I-AM-ENGINEER/Seismometer-esp32/README.md

#Work in progress

# Seismometer-esp32
ESP32 based wifi vibration &amp; sound sensor with realtime streaming captured audio throught mqtt
