I-AM-ENGINEER/Seismometer-esp32/PCB/v1.0/README.md

#First prototype

##Errors:

1) R10 should be connected to VREF, not to GND
2) Microphone amplifier (U8) is broken, maybe contrafact IC

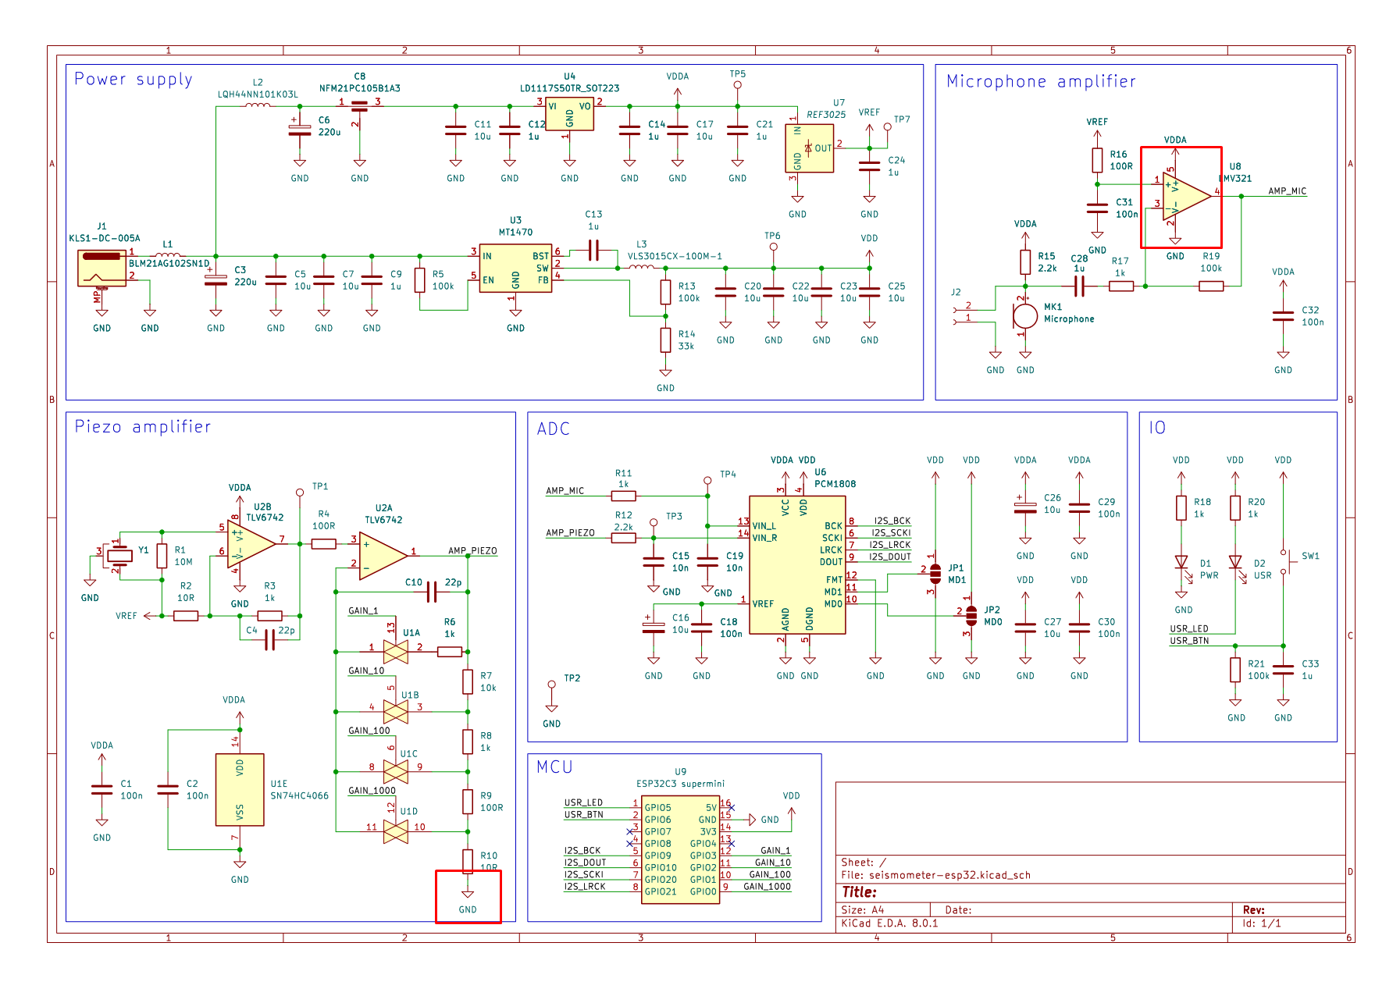
[picture p1: PCB/v1.0/Schematic.png]
Schematic Schematic with highlighted errors
