I-AM-ENGINEER/Seismometer-esp32/MyResearch/tsf_samplerates_compare/README.md

FreeRTOS reconfigured for 1000Hz tickrate
