I-AM-ENGINEER/Seismometer-esp32/MyResearch/tsf_mesh_function_compare/data/README.md

Every file contan 5min capture (period 100ms) with 3 value:

timer_value1	tsf_function_value	timer_value2

Timer clock 40MHz, tsf_function return AP timestamp in microseconds. Timer value captured before and after tsf function for getting function process time
