I-AM-ENGINEER/Seismometer-esp32/Docs/Блок-схема/Блок схема.png

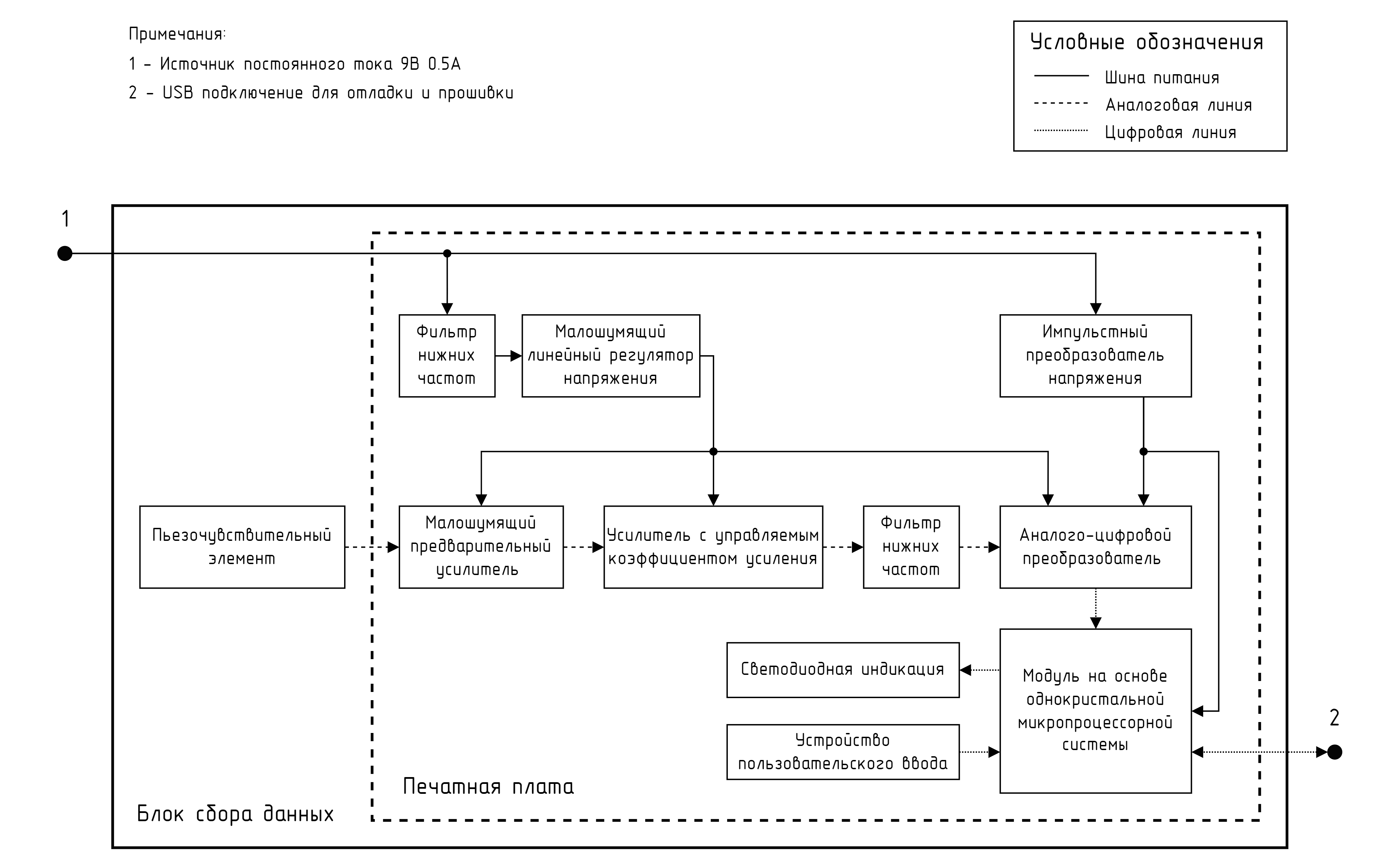
Docs/Блок-схема/Блок схема.png
