I-AM-ENGINEER/Seismometer-esp32/PCB/v1.0/BOM.xlsx

Reference | Value | Qty
C1,C2,C18,C29,C30,C31,C32 | 100n | 7
C3,C6 | 220u | 2
C4,C10 | 22p | 2
C5,C7,C11,C16,C17,C20,C22,C23,C25,C26,C27 | 10u | 11
C8 | NFM21PC105B1A3 | 1
C9,C12,C13,C14,C21,C24,C28,C33 | 1u | 8
C15,C19 | 10n | 2
J1 | KLS1-DC-005A | 1
L1 | BLM21AG102SN1D | 1
L2 | LQH44NN101K03L | 1
L3 | VLS3015CX-100M-1 | 1
MK1 | Microphone | 1
R1 | 10M | 1
R2,R10 | 10R | 2
R3,R6,R8,R11,R17,R18,R20 | 1k | 7
R4,R9,R16 | 100R | 3
R5,R13,R19,R21 | 100k | 4
R7 | 10k | 1
R12,R15 | 2.2k | 2
R14 | 33k | 1
U1 | SN74HC4066 | 1
U2 | TLV6742 | 1
U3 | MT1470 | 1
U4 | LD1117S50TR_SOT223 | 1
U6 | PCM1808 | 1
U7 | REF3025 | 1
