I-AM-ENGINEER/Seismometer-esp32/PCB/v1.0/seismometer-esp32.step

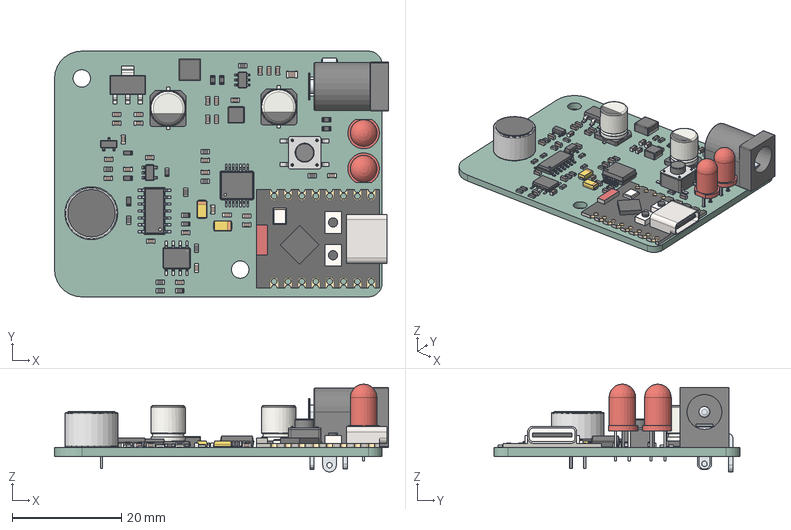
[picture p3: CAD file, 2024-10-25]
PCB/v1.0/seismometer-esp32.step
61.2 x 45.0 x 16.1 mm
CP_Elec_63x77 x 2
L_Cenker_CKCS3015
SSOP_8_39x505mm_P127mm
C_0603_1608Metric x 28
R_0603_1608Metric x 21
SOT_23
SOT_223
LED_D5.0mm x 2
TSOT_23_6
Microphone
CP_EIA_3216_12_Kemet_S x 2
Small_pushbutton_pad
SOT_23_5
ESP32-C3 SuperMini
C_0805_2012Metric
L_Cenker_CKCS4020
CQ assembly
DC_Barrel_Assy
SSOP_14_53x62mm_P065mm
seismometer-esp32_PCB
