I-AM-ENGINEER/Seismometer-esp32/(list of files, cad)

Other CAD files:
Case/35mm-sensor.ipt
Case/Assembly.iam
Case/Assembly1.iam
Case/ESP32-C3 SuperMini.ipt
Case/Main body.ipt
Case/Part1.ipt
Case/Part2.ipt
Case/seismometer-esp32.ipt
