I-AM-ENGINEER/Seismometer-esp32/PCB/v1.0/seismometer-esp32.pdf

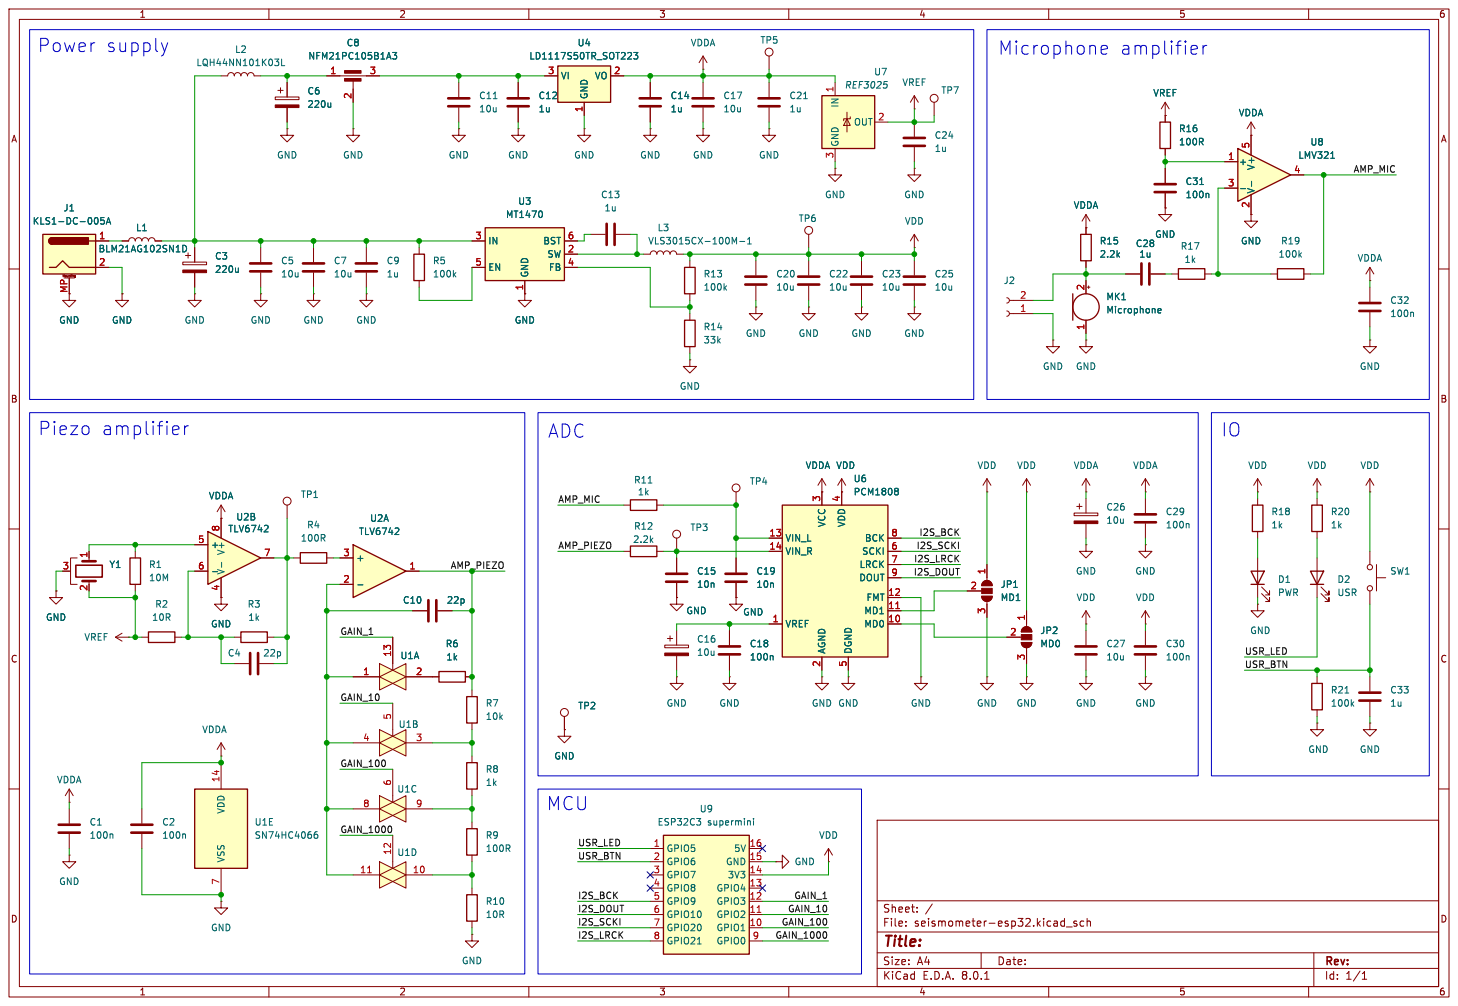
[picture p4: page 1]

Id: 1/1 Title: File: seismometer-esp32.kicad_sch Sheet: / GND

LRCK 7 BCK 8 DOUT 9 VDDA VDD GND

LRCK 7 BCK 8 DOUT 9 U6PCM1808 VDDA
