I-AM-ENGINEER/Seismometer-esp32/Docs/PCB-altium/Export/Schematic.pdf

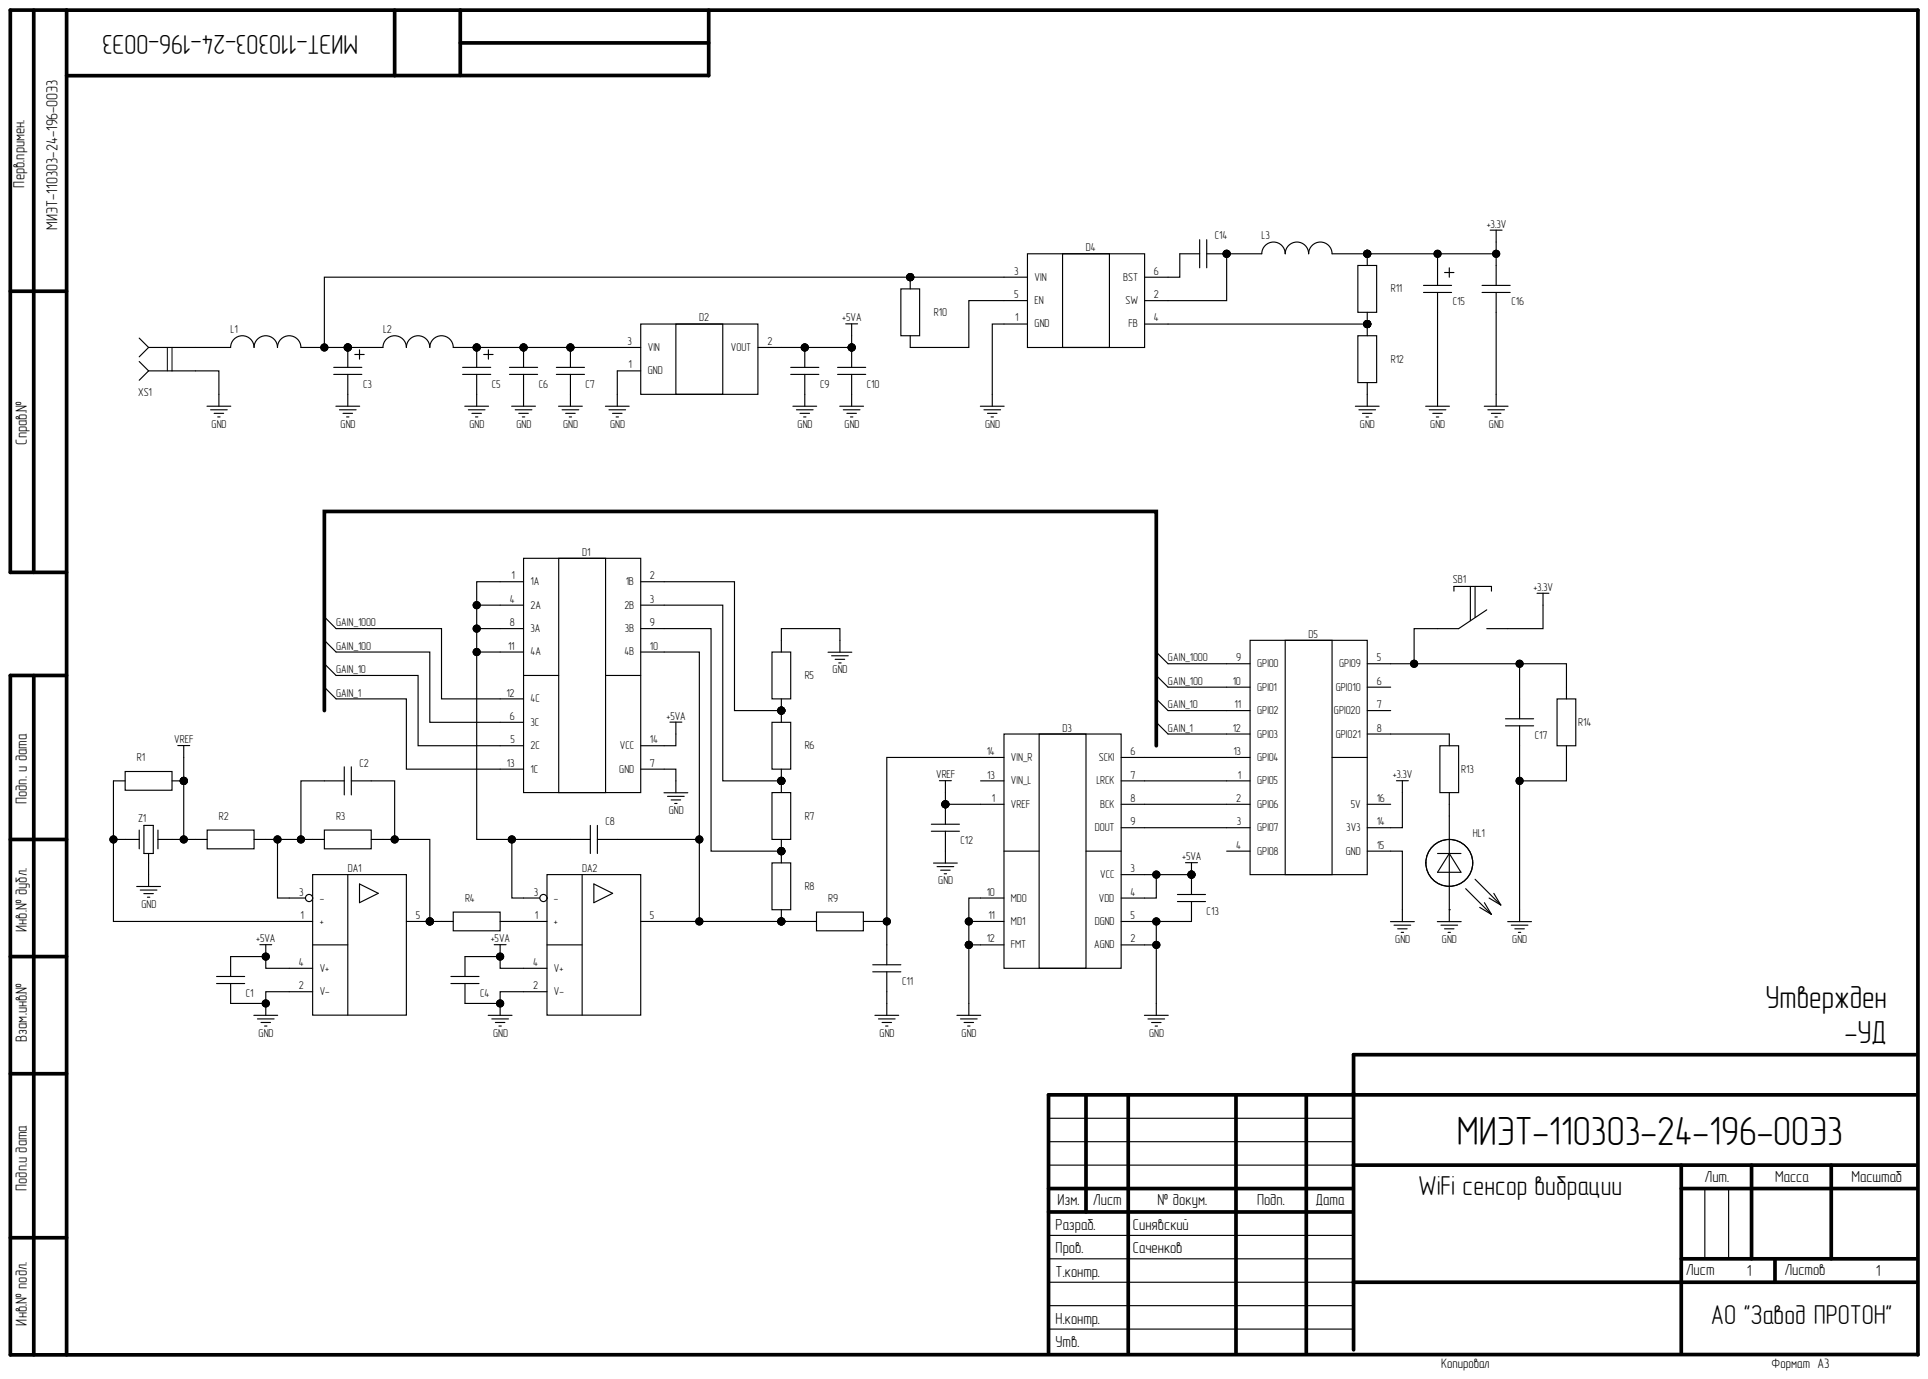
[picture p5: page 1]

Инв.№ подл. Подп.и дата Взам.инв.№ Инв.№ дубл. Подп. и дата Справ.№ Перв.примен.

VIN 3 | SW

GND 1

GAIN_100 | | | | 10

GAIN_10 | | | | | 14

GAIN_1 | | 4C 12 | | VCC

МИЭТ-110303-24-196-00Э3

WiFi сенсор вибрации | Лит. | Масса | Масштаб

Изм. | Лист | № докум. | Подп. | Дата
Разраб. | | Синявский
Пров. | | Саченков
Т.контр. | | | | | Лист 1 | Листов 1

Н.контр.
Утв.

АО "Завод ПРОТОН"
