I-AM-ENGINEER/Seismometer-esp32/Docs/PCB-altium/Export/Сборочный.pdf

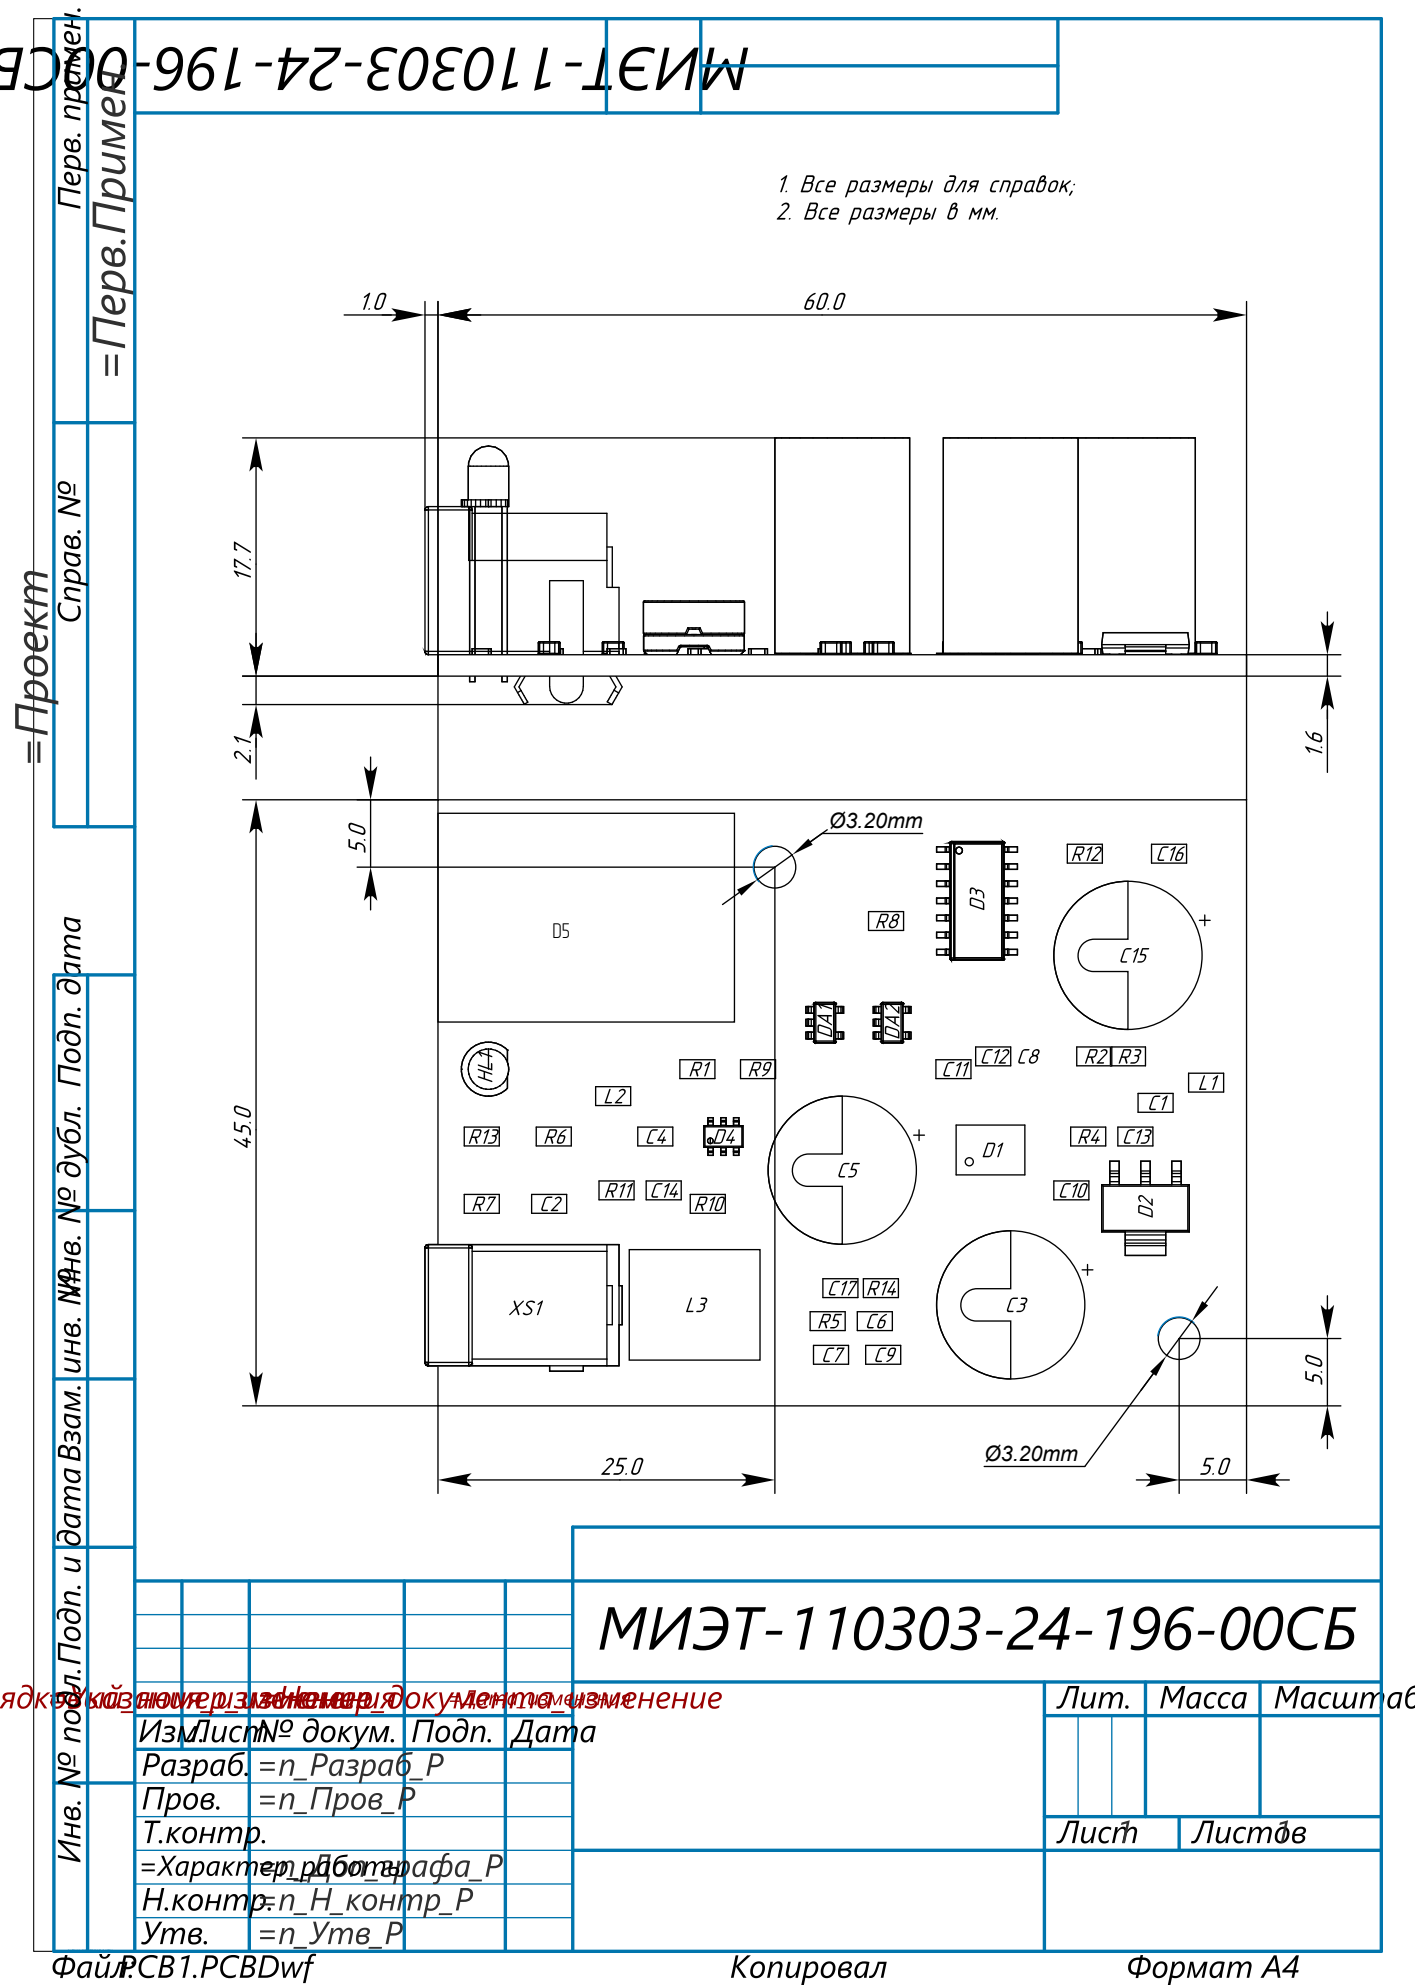
[picture p6: page 1]
ALTIUM GOSTBOM2.0 KEV
