I-AM-ENGINEER/Seismometer-esp32/(list of files, drawings)

Other design files:
Docs/PCB-altium/PCB1.PcbDoc
Docs/PCB-altium/Schlib1.SchLib
Docs/PCB-altium/SeismometerAltium.PrjPcb
Docs/PCB-altium/Sheet1.SchDoc
