I-AM-ENGINEER/Seismometer-esp32/PCB/v1.0/seismometer-esp32.kicad_pcb

## KiCad design PCB/v1.0/seismometer-esp32.kicad_pcb (2024-10-25)

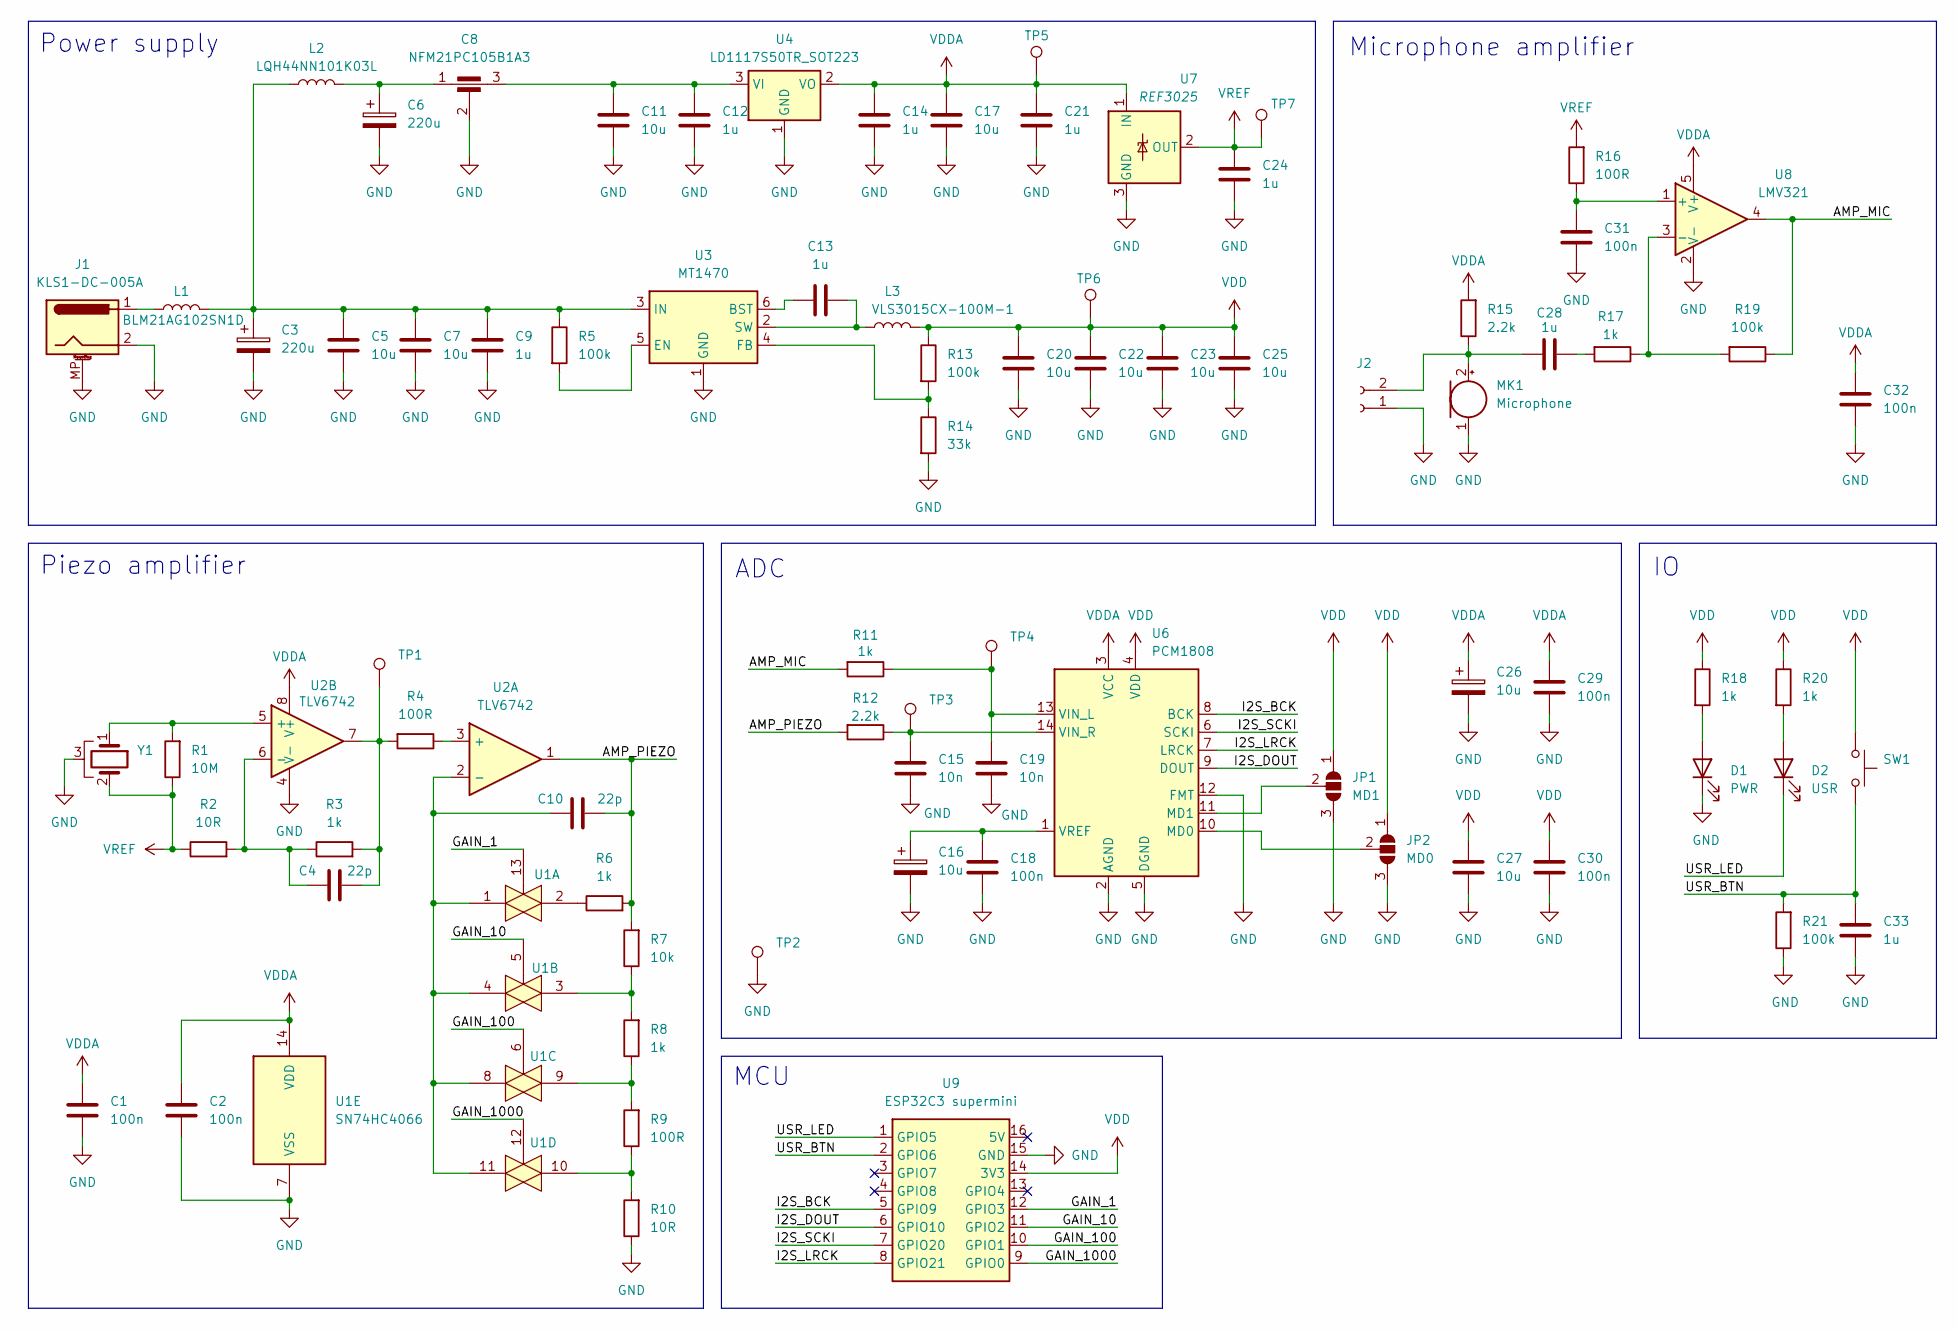
[picture p7: schematic seismometer-esp32.kicad_sch]

Parts:
C1, C2, C18, C29, C30, C31, C32: 100n; C_0603_1608Metric_Pad1.08x0.95mm_HandSolder
C3, C6: 220u; CP_Elec_6.3x7.7
C4, C10: 22p; C_0603_1608Metric_Pad1.08x0.95mm_HandSolder
C5, C7, C11, C17, C20, C22, C23, C25, C27: 10u; C_0603_1608Metric_Pad1.08x0.95mm_HandSolder
C8: NFM21PC105B1A3; NFM21PC
C9, C12, C13, C14, C21, C24, C28, C33: 1u; C_0603_1608Metric_Pad1.08x0.95mm_HandSolder
C15, C19: 10n; C_0603_1608Metric_Pad1.08x0.95mm_HandSolder
C16, C26: 10u; CP_EIA-3216-12_Kemet-S_Pad1.58x1.35mm_HandSolder
D1: PWR; LED_D5.0mm
D2: USR; LED_D5.0mm
J1: KLS1-DC-005A; BarrelJack_Kycon_KLDX-0202-xC_Horizontal
J2: Conn_01x02_Socket; PinHeader_1x02_P2.00mm_Vertical
JP1: MD1; SolderJumper-3_P1.3mm_Open_RoundedPad1.0x1.5mm
JP2: MD0; SolderJumper-3_P1.3mm_Open_RoundedPad1.0x1.5mm
L1: BLM21AG102SN1D; C_0805_2012Metric
L2: LQH44NN101K03L; L_Taiyo-Yuden_NR-40xx_HandSoldering
L3: VLS3015CX-100M-1; L_Taiyo-Yuden_NR-30xx_HandSoldering
MK1: Microphone; DGO9465CD
R1: 10M; R_0603_1608Metric_Pad0.98x0.95mm_HandSolder
R2, R10: 10R; R_0603_1608Metric_Pad0.98x0.95mm_HandSolder
R3, R6, R8, R11, R17, R18, R20: 1k; R_0603_1608Metric_Pad0.98x0.95mm_HandSolder
R4, R9, R16: 100R; R_0603_1608Metric_Pad0.98x0.95mm_HandSolder
R5, R13, R19, R21: 100k; R_0603_1608Metric_Pad0.98x0.95mm_HandSolder
R7: 10k; R_0603_1608Metric_Pad0.98x0.95mm_HandSolder
R12, R15: 2.2k; R_0603_1608Metric_Pad0.98x0.95mm_HandSolder
R14: 33k; R_0603_1608Metric_Pad0.98x0.95mm_HandSolder
SW1: SW_Push; SW_Push_1P1T_NO_6x6mm_H9.5mm
TP1, TP2, TP3, TP4, TP5, TP6, TP7: TestPoint; TestPoint_Pad_D2.0mm
U1: SN74HC4066; SO-14_3.9x8.65mm_P1.27mm
U2: TLV6742; SSOP-8_3.9x5.05mm_P1.27mm
U3: MT1470; TSOT-23-6
U4: LD1117S50TR_SOT223; SOT-223-3_TabPin2
U6: PCM1808; SSOP-14_5.3x6.2mm_P0.65mm
U7: REF3025; SOT-23
U8: LMV321; SOT-23-5
U9: ESP32C3 supermini; ESP32C3-supermini
Y1: Crystal_GND3; Shielded cable 2pin

Connections:
/AMP_MIC: R11.2, R19.1, U8.4
/AMP_PIEZO: C10.2, R6.2, R7.2, R12.2, U2.1
/GAIN_1: U1.13, U9.12 (GPIO3)
/GAIN_10: U1.5, U9.11 (GPIO2)
/GAIN_100: U1.6, U9.10 (GPIO1)
/GAIN_1000: U1.12, U9.9 (GPIO0)
/I2S_BCK: U6.8 (BCK), U9.5 (GPIO9)
/I2S_DOUT: U6.9 (DOUT), U9.6 (GPIO10)
/I2S_LRCK: U6.7 (LRCK), U9.8 (GPIO21)
/I2S_SCKI: U6.6 (SCKI), U9.7 (GPIO20)
/USR_BTN: C33.1, R21.2, SW1.2, U9.2 (GPIO6)
/USR_LED: D2.1 (K), U9.1 (GPIO5)
GND: C1.2, C2.2, C3.2, C5.2, C6.2, C7.2, C8.2, C9.2, C11.2, C12.2, C14.2, C15.2, C16.2, C17.2, C18.2, C19.2, C20.2, C21.2, C22.2, C23.2, C24.2, C25.2, C26.2, C27.2, C29.2, C30.2, C31.1, C32.2, C33.2, D1.1 (K), J1.2, J1.MP (MountPin), J2.1, JP1.3 (B), JP2.3 (B), MK1.1 (-), R10.1, R14.2, R21.1, TP2.1, U1.7 (VSS), U2.4 (V-), U3.1 (GND), U4.1 (GND), U6.2 (AGND), U6.5 (DGND), U6.12 (FMT), U7.3 (GND), U8.2 (V-), U9.15 (GND), Y1.3
unnamed: C4.2, R3.2, R4.2, TP1.1, U2.7
unnamed: C6.1, C8.1, L2.2
unnamed: C28.2, R17.2
unnamed: D1.2 (A), R18.2
unnamed: D2.2 (A), R20.2
unnamed: J1.1, L1.1
unnamed: C28.1, J2.2, MK1.2 (+), R15.1
unnamed: JP1.2 (C), U6.11 (MD1)
unnamed: JP2.2 (C), U6.10 (MD0)
unnamed: R6.1, U1.2
unnamed: R7.1, R8.2, U1.3
unnamed: R8.1, R9.2, U1.9
unnamed: R9.1, R10.2, U1.10
unnamed: R4.1, U2.3 (+)
unnamed: C10.1, U1.1, U1.4, U1.8, U1.11, U2.2 (-)
unnamed: R1.2, U2.5 (+), Y1.1
unnamed: C4.1, R2.2, R3.1, U2.6 (-)
unnamed: C13.1, U3.6 (BST)
unnamed: R5.2, U3.5 (EN)
unnamed: R13.2, R14.1, U3.4 (FB)
unnamed: C3.1, C5.1, C7.1, C9.1, L1.2, L2.1, R5.1, U3.3 (IN)
unnamed: C13.2, L3.1, U3.2 (SW)
unnamed: C8.3, C11.1, C12.1, U4.3 (VI)
unnamed: C19.1, R11.1, TP4.1, U6.13 (VIN_L)
unnamed: C15.1, R12.1, TP3.1, U6.14 (VIN_R)
unnamed: C16.1, C18.1, U6.1 (VREF)
unnamed: C31.2, R16.1, U8.1 (+)
unnamed: R17.1, R19.2, U8.3 (-)
VDD: C20.1, C22.1, C23.1, C25.1, C27.1, C30.1, JP1.1 (A), JP2.1 (A), L3.2, R13.1, R18.1, R20.1, SW1.1, TP6.1, U6.4 (VDD), U9.14 (3V3)
VDDA: C1.1, C2.1, C14.1, C17.1, C21.1, C26.1, C29.1, C32.1, R15.2, TP5.1, U1.14 (VDD), U2.8 (V+), U4.2 (VO), U6.3 (VCC), U7.1 (IN), U8.5 (V+)
VREF: C24.1, R1.1, R2.1, R16.2, TP7.1, U7.2 (OUT), Y1.2

Notes on the sheet:
ADC
Power supply
Piezo amplifier
Microphone amplifier
MCU

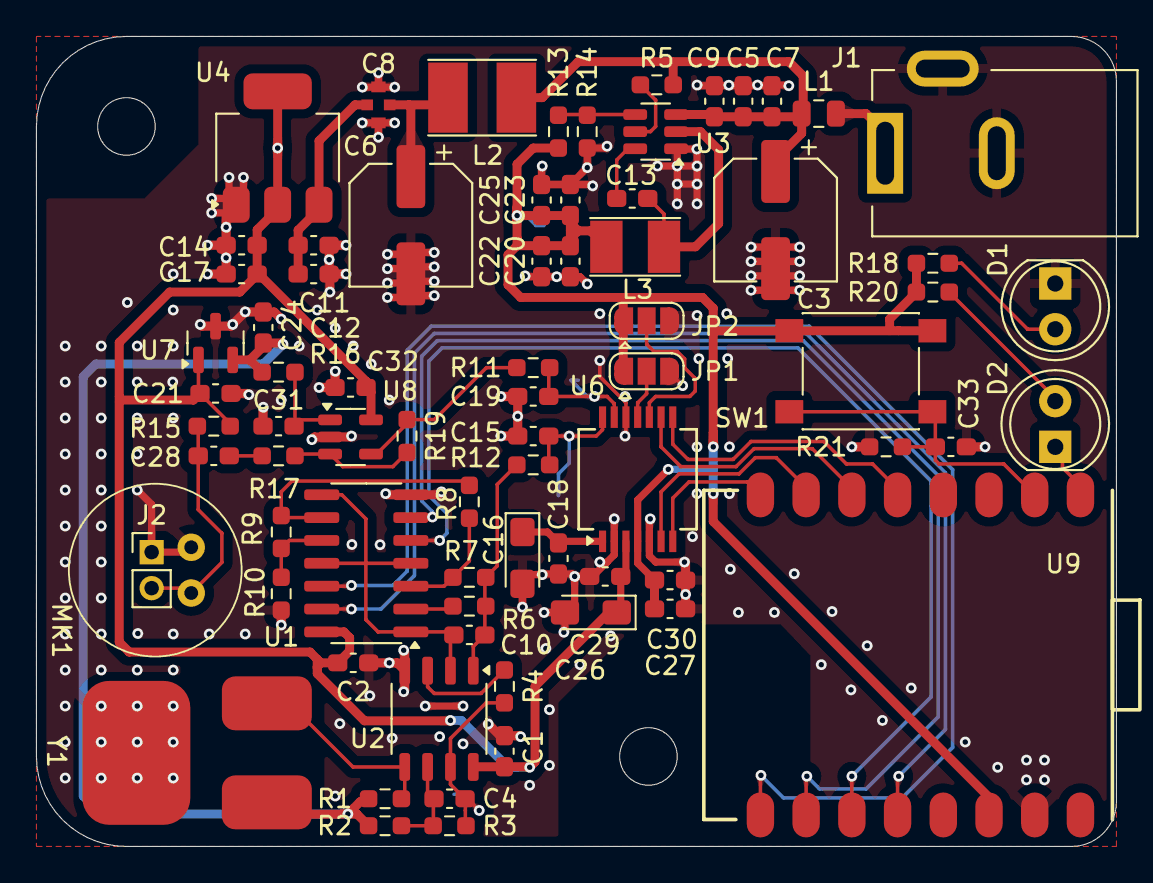
[picture p8: board seismometer-esp32.kicad_pcb from above]

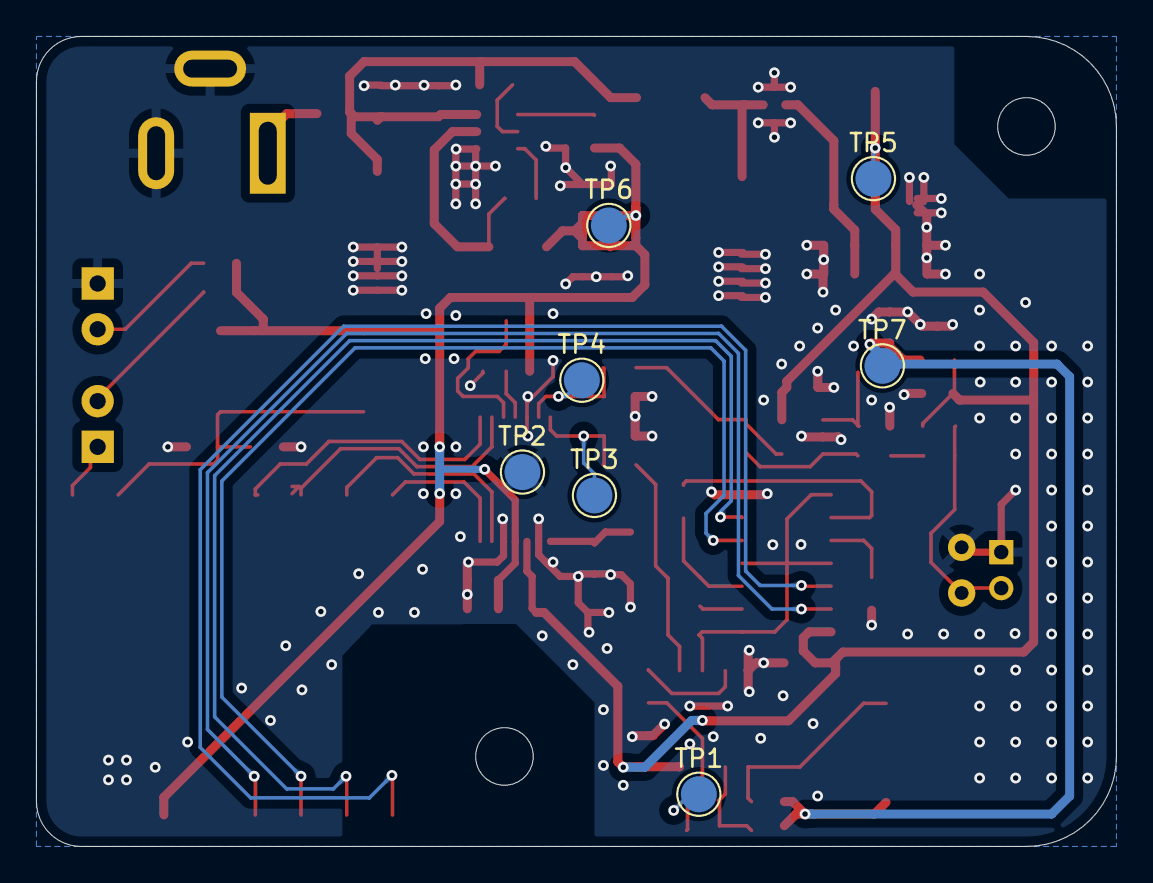
[picture p9: board seismometer-esp32.kicad_pcb from below]

Board: 2 copper layers, 60.0 x 45.0 mm, 81 parts (7 on the bottom side), 44 nets.
