I-AM-ENGINEER/Seismometer-esp32/(commit log)

2024-09-17 PCB upload
    [BOM.xlsx, seismometer-esp32.kicad_pcb, seismometer-esp32.kicad_sch]
2024-10-25 3d models & case
    [35mm-sensor.ipt, Assembly.iam, Assembly1.iam, ESP32-C3 SuperMini.ipt, Main body.ipt, Part1.ipt, Part2.ipt, seismometer-esp32.ipt]
2025-02-01 Before changes I2S driver
    [PCB1.PcbDoc, Schlib1.SchLib, SeismometerAltium.PrjPcb, Sheet1.SchDoc]
2025-02-12 MQTT + simple DSP
    [seismometer-esp32.kicad_sch]
2025-02-13 Almost work, but i2s jitter
    [I2S_Task.hpp, MQTT.cpp, PrecisionTimeTask.hpp, WiFiTask.hpp, config.h, dsp.cpp, i2s.cpp]
2025-02-18 Better timestamp with Theil–Sen
